Jehka/miniNOC/pictures/bench.JPG

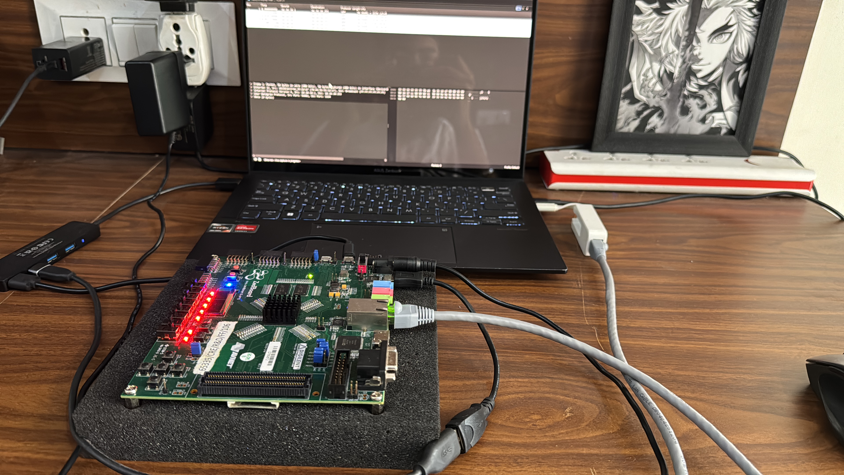
pictures/bench.JPG
