Jehka/miniNOC/pictures/implementation.png

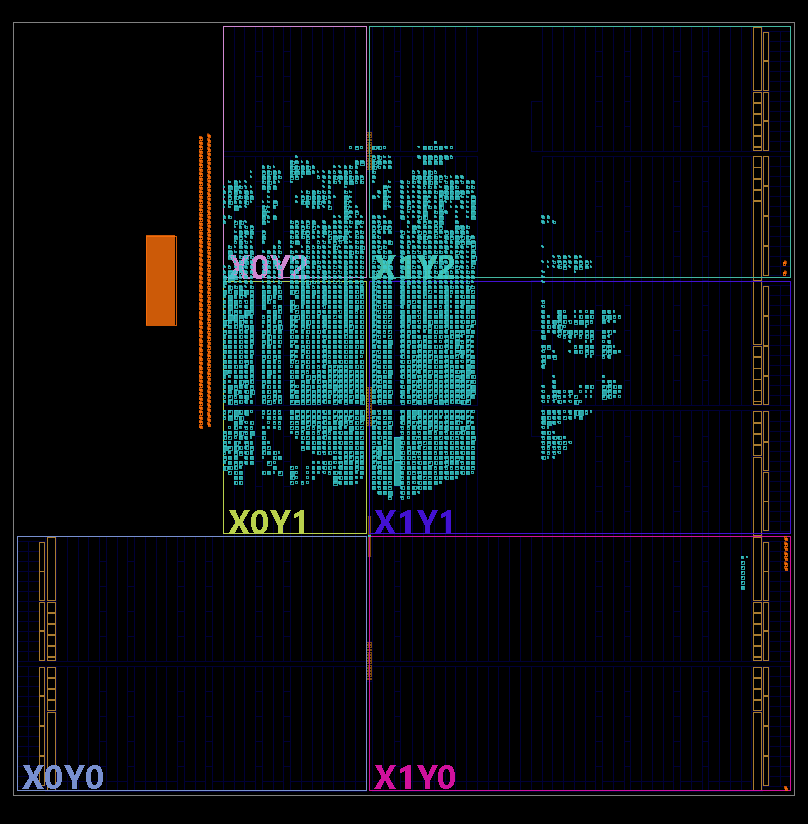
pictures/implementation.png
