Jehka/miniNOC/pictures/n1_pass.png

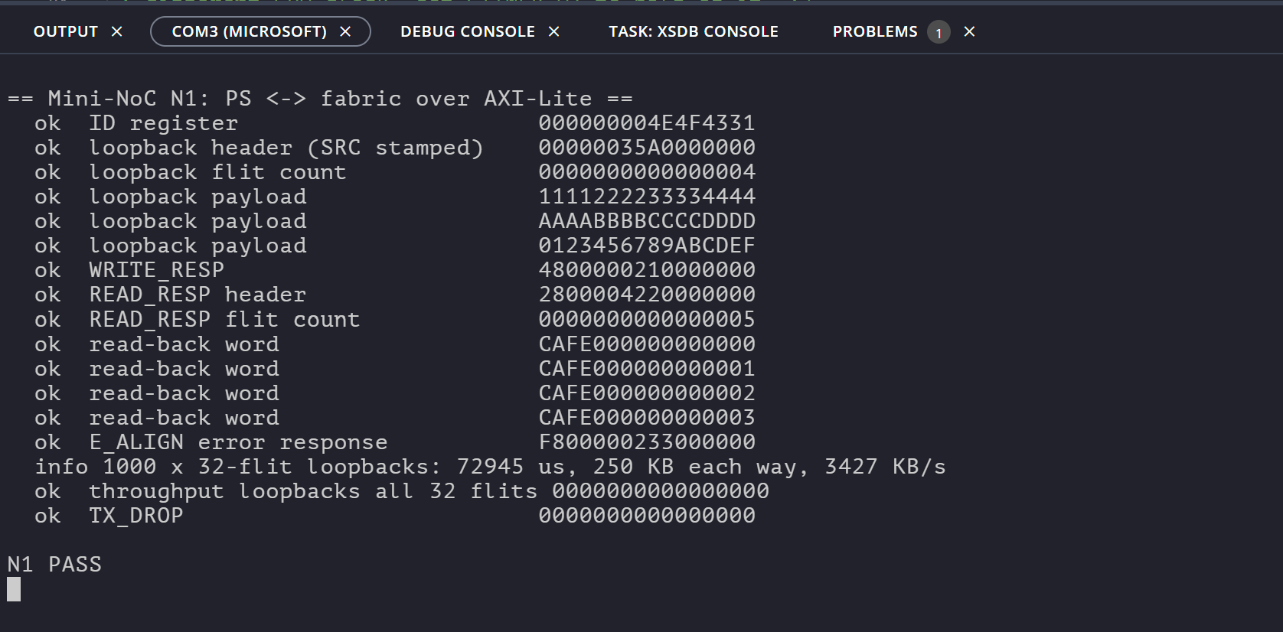
pictures/n1_pass.png
