Jehka/miniNOC/pictures/n3.png

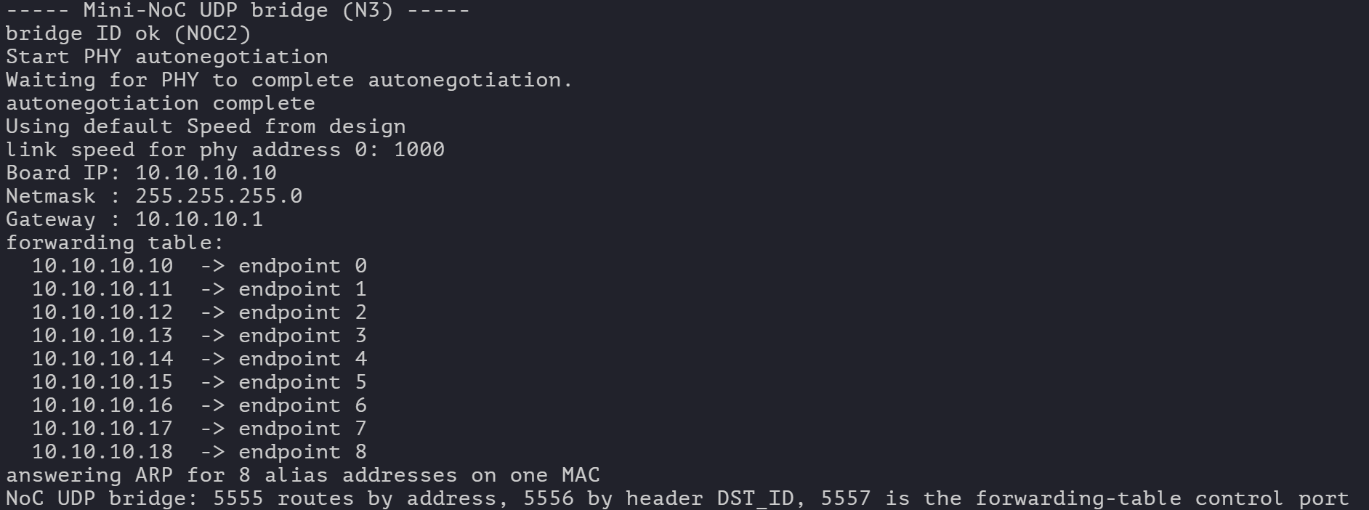
pictures/n3.png
