Jehka/miniNOC/pictures/n5.png

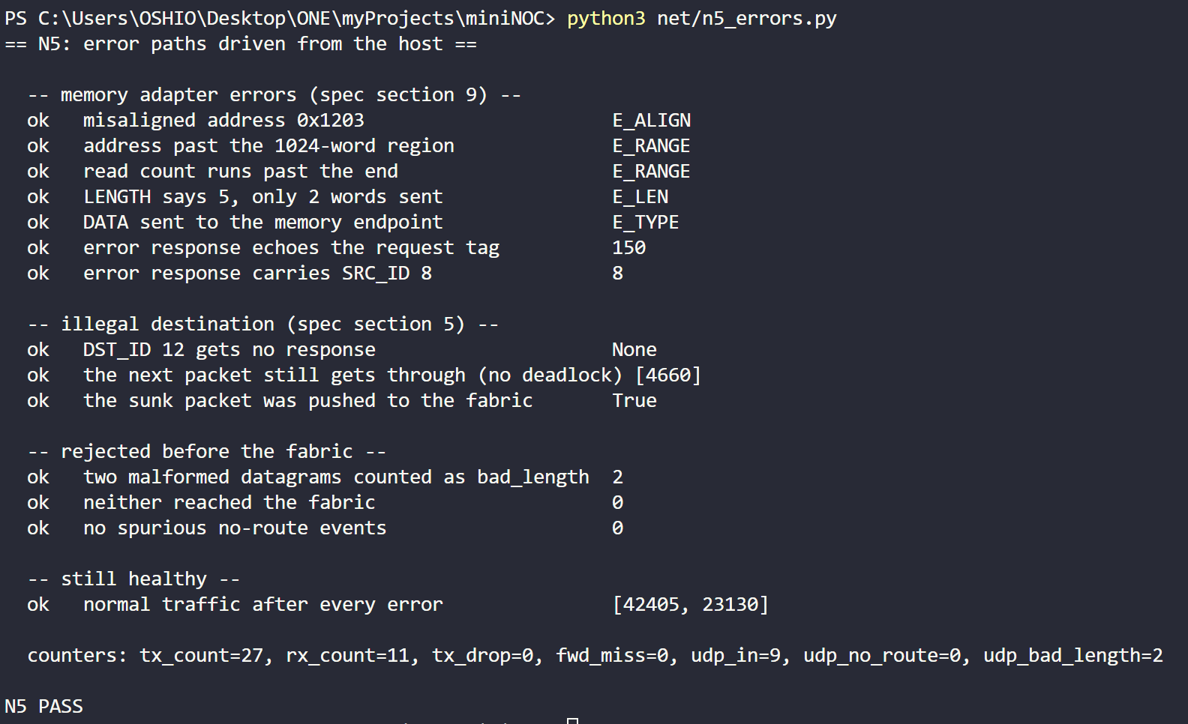
pictures/n5.png
