Jehka/miniNOC/pictures/ping2.png

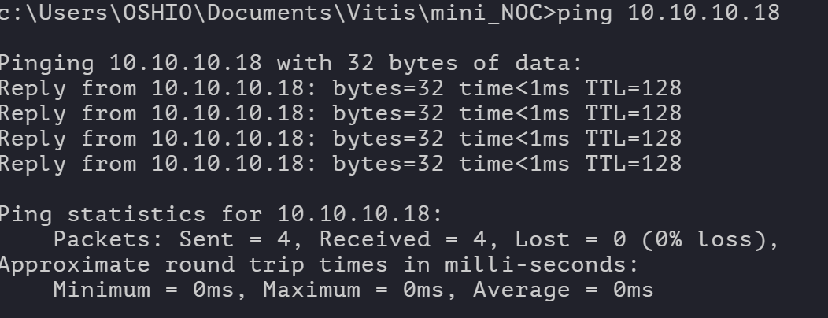
pictures/ping2.png
