Jehka/miniNOC/pictures/utilisation.png

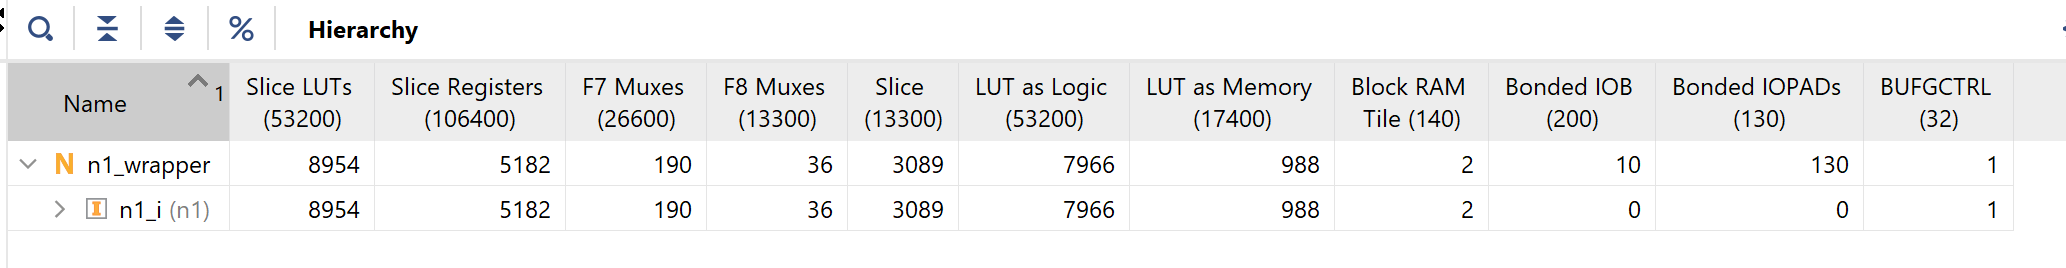
pictures/utilisation.png
