Jehka/miniNOC/pictures/wireshark_n5.png

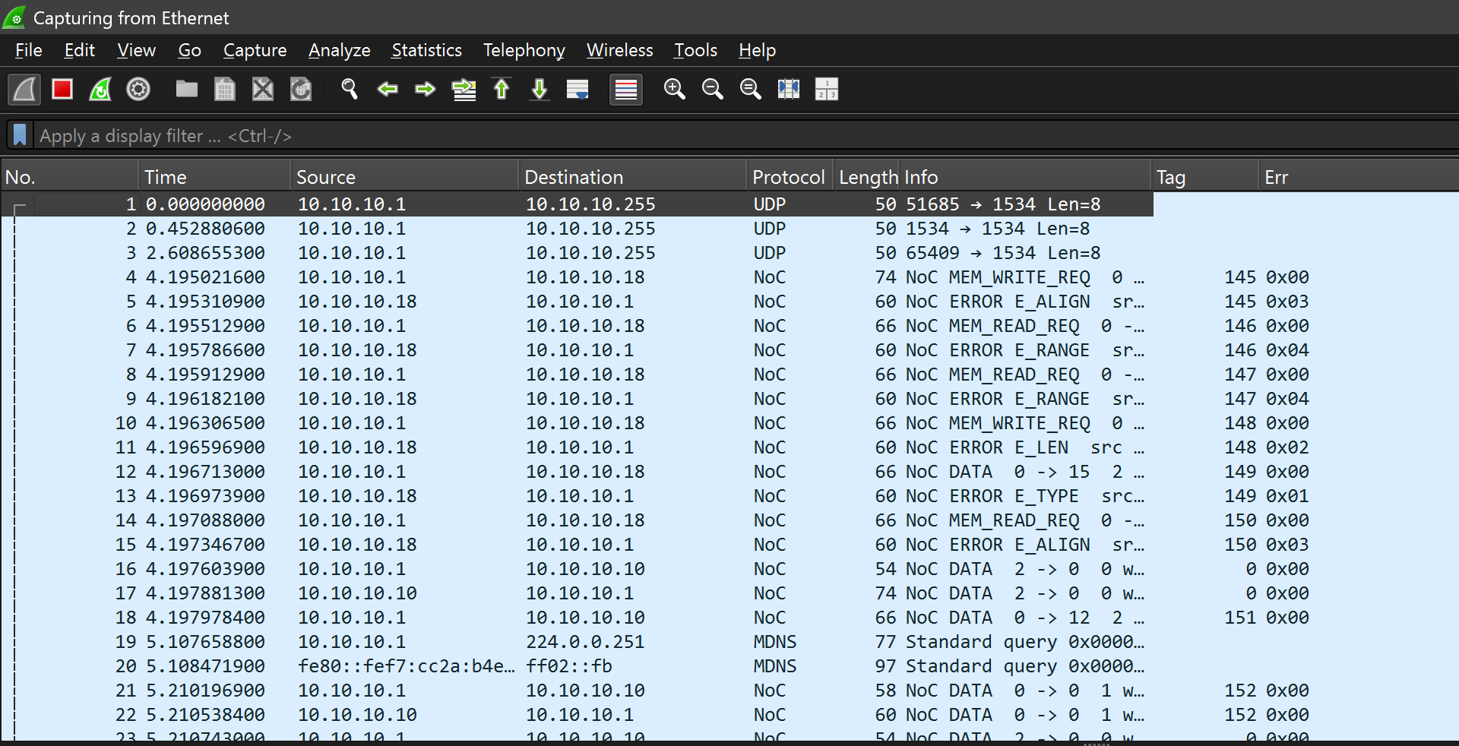
pictures/wireshark_n5.png
