Jehka/miniNOC/pictures/wireshark_n5_dst.png

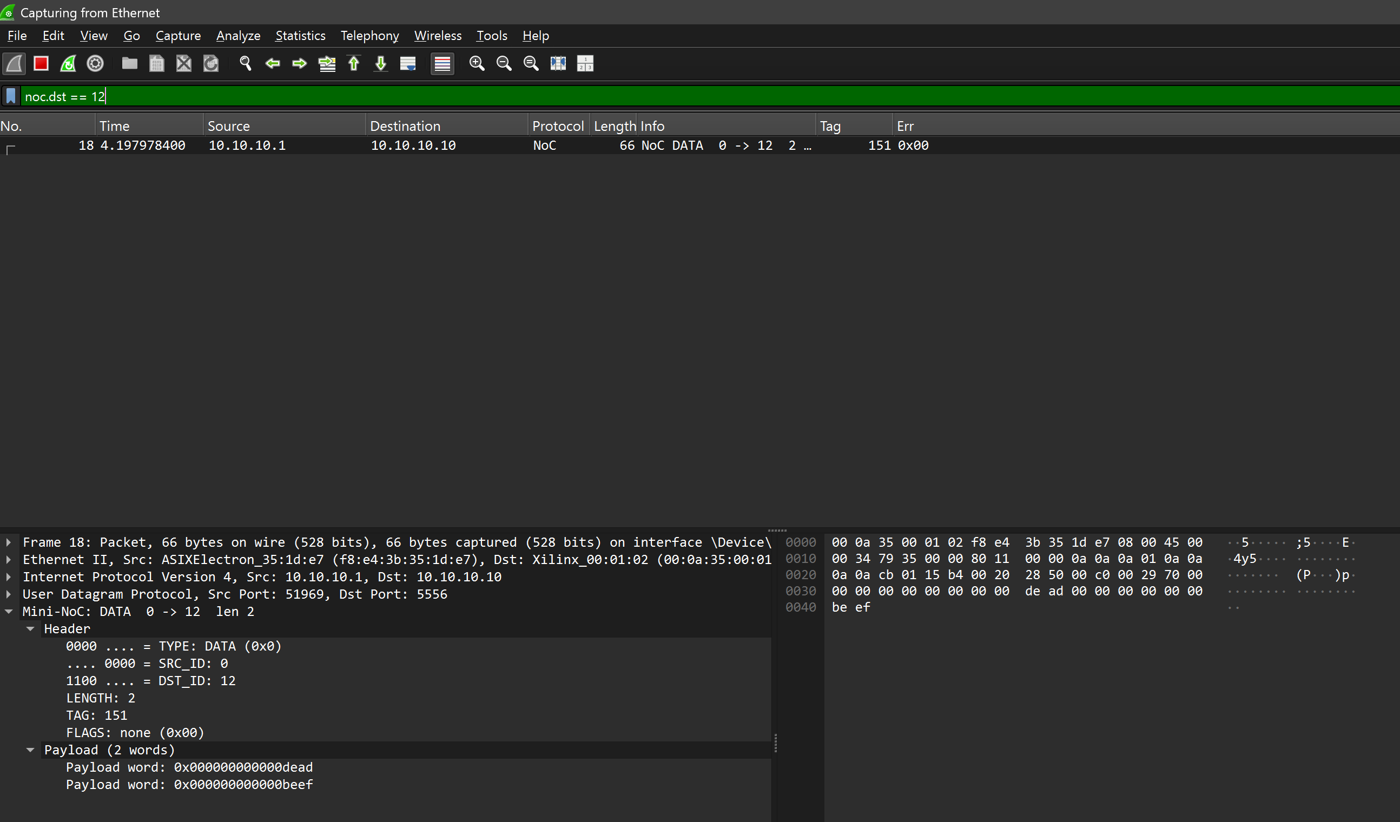
pictures/wireshark_n5_dst.png
