Jehka/miniNOC/pictures/wireshark_n5_trunc.png

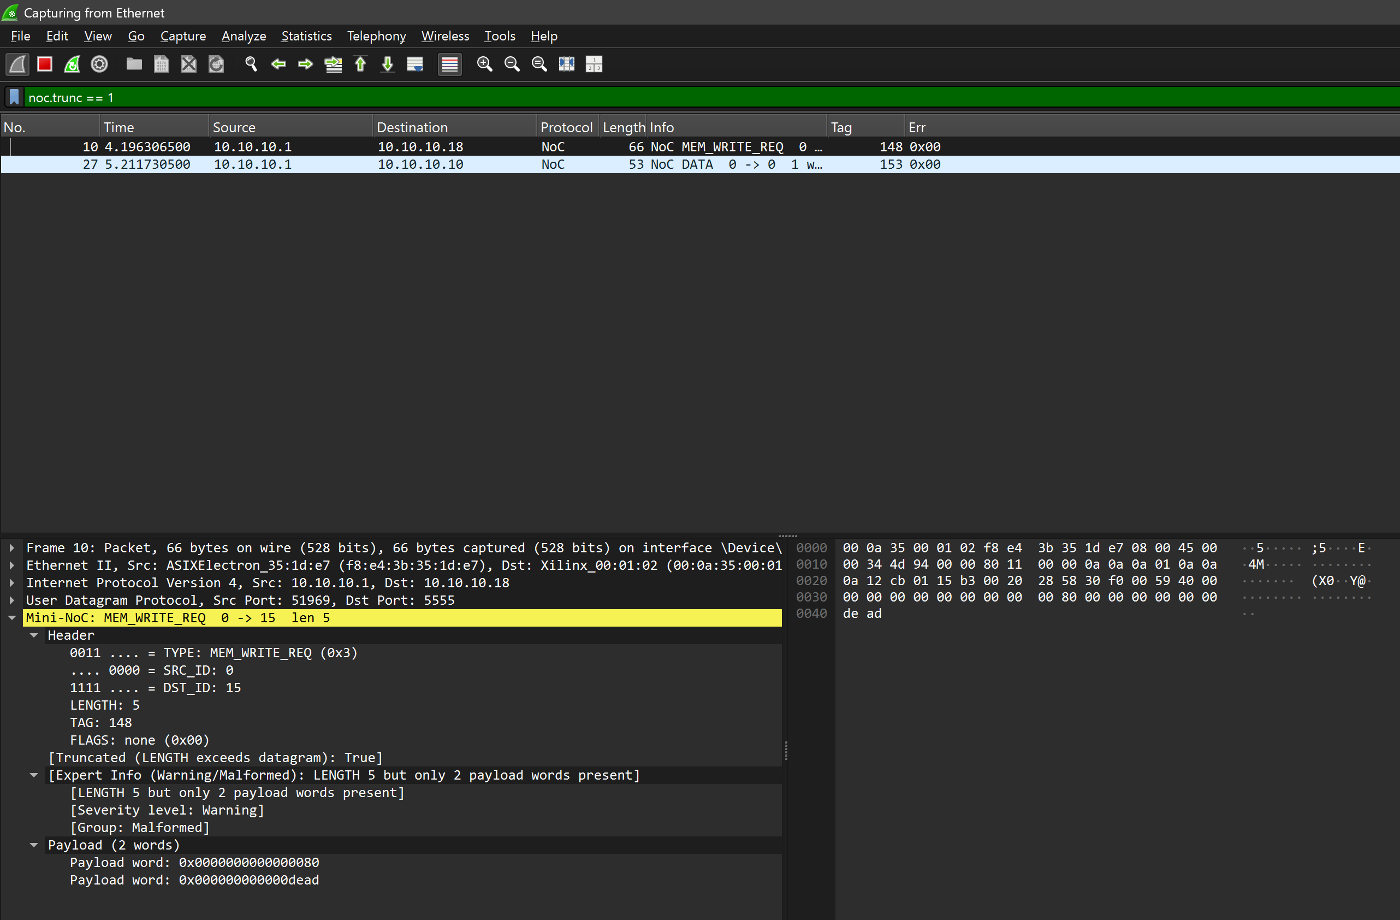
pictures/wireshark_n5_trunc.png
