Jehka/miniNOC/pictures/wireshark_n6.png

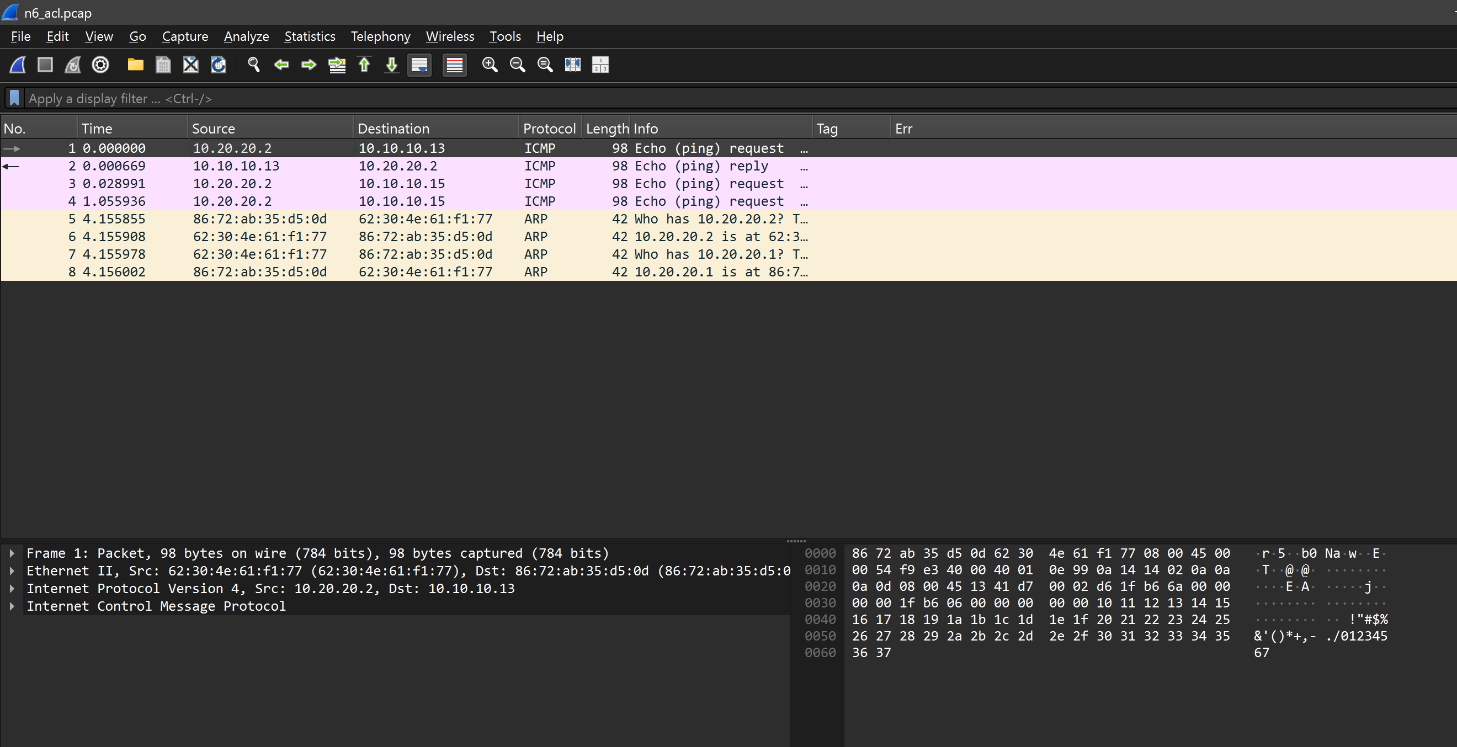
pictures/wireshark_n6.png
