Jehka/miniNOC/fpga/n1.xdc

## n1.xdc -- stage N1 board I/O. The clock comes from the PS (FCLK_CLK0), so
## there is no GCLK pin and no create_clock here: the PS IP constrains it.
## Check bank 34/35 IOSTANDARD against the VADJ jumper (J18), as in zedboard.xdc.
set_property -dict {PACKAGE_PIN F22 IOSTANDARD LVCMOS18} [get_ports {sw[0]}]
set_property -dict {PACKAGE_PIN G22 IOSTANDARD LVCMOS18} [get_ports {sw[1]}]
set_property -dict {PACKAGE_PIN T22 IOSTANDARD LVCMOS33} [get_ports {led[0]}]
set_property -dict {PACKAGE_PIN T21 IOSTANDARD LVCMOS33} [get_ports {led[1]}]
set_property -dict {PACKAGE_PIN U22 IOSTANDARD LVCMOS33} [get_ports {led[2]}]
set_property -dict {PACKAGE_PIN U21 IOSTANDARD LVCMOS33} [get_ports {led[3]}]
set_property -dict {PACKAGE_PIN V22 IOSTANDARD LVCMOS33} [get_ports {led[4]}]
set_property -dict {PACKAGE_PIN W22 IOSTANDARD LVCMOS33} [get_ports {led[5]}]
set_property -dict {PACKAGE_PIN U19 IOSTANDARD LVCMOS33} [get_ports {led[6]}]
set_property -dict {PACKAGE_PIN U14 IOSTANDARD LVCMOS33} [get_ports {led[7]}]
set_false_path -from [get_ports {sw[*]}]
set_false_path -to   [get_ports {led[*]}]
