Jehka/miniNOC/(commit log)

2026-09-21 Track B: N1 bridge and N4 forwarding table verified on hardware
2026-09-24 wireshark testing
